hventer/comp4060/Code/Other Code/Temperature Module/Temperature.rtf

https://www.circuitbasics.com/how-to-set-up-the-dht11-humidity-sensor-on-an-arduino/
WORKS

https://create.arduino.cc/projecthub/MisterBotBreak/how-to-use-temperature-and-humidity-dht-sensors-9e5975
https://www.jaycar.com.au/arduino-compatible-temperature-and-humidity-sensor-module/p/XC4520
