hventer/comp4060/Documentation/Project Plan.pdf

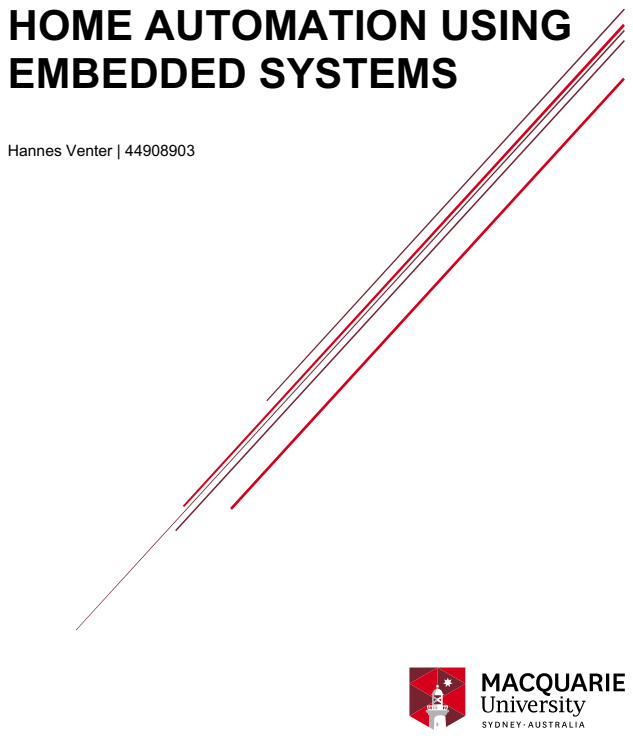
[picture p14: page 1]
Hannes Venter | 44908903

HOME AUTOMATION USING
EMBEDDED SYSTEMS

i

## Table of Contents

ii

iii

## Document Version Record

Table 1 - Table of document versions and revisions

Version | Date | Description | Author
0.0.1 | 18/3/20 | Initial thoughts on CPD project. Began a list of dot-points with ideas for CPD projects. | Hannes Venter
0.0.2 | 19/3/20 | Created Title Page and TOC. Further filled in ideas for CPD project. | Hannes Venter
0.0.3 | 20/3/20 | Selected Final Idea. Wrote topic and motivation. | Hannes Venter
0.0.4 | 22/3/20 | Finalised project timeline and first ideas about how to achieve the project. | Hannes Venter
0.1 | 22/3/20 | Finalised version 0.1 | Hannes Venter
0.1.1 | 25/3/20 | Taking feedback into consideration and improving formality of plan. | Hannes Venter
0.1.2 | 25/3/20 | Moving Initial Plans and Further Motivation into Appendices | Hannes Venter
0.1.3 | 26/3/20 | Further explanation of hardware, software and knowledge | Hannes Venter
0.1.4 | 27/3/20 | Research and selection of hardware and software | Hannes Venter
0.1.5 | 28/3/20 | Purchase and description of hardware and software | Hannes Venter
0.2 | 29/3/20 | Finalised version 0.2 | Hannes Venter
0.2.1 | 4/4/20 | Added pictures to Arduino and Sensors. Added plan diagrams (section 4.4) | Hannes Venter
0.2.2 | 5/4/20 | Improved and added detail to project timeline (section 4.5). Added future expandability section. | Hannes Venter
0.2.3 | 6/4/20 | Proof-read document and made spelling and gramatical improvements. | Hannes Venter
1.0.0 | 6/4/20 | Finalised document (version 1.0.0) | Hannes Venter

## 1. Introduction

This project will consist of 2 smaller projects, both centred around home-automation. The projects will both be embedded systems and will vary in complexity as they progress. Appendix I provides explanations of additional project considerations.

### 1.1 Ceiling Vents

The first project will create a system which draws hot air out of the ceiling, thus cooling the house. A fan will be placed inside the ceiling space with its exhaust directing outwards through a vent. The fan will be enabled once the temperature inside the ceiling reaches above a certain temperature and will run until the ceiling is sufficiently cooled. Light sensors will be implemented to alter the power settings and ensure that the fan is quiet during the night.

### 1.2 Automatic Blinds

The second project will be more complex. This project will enable external blinds to be gradually lowered in front of windows as the sun sets. An array of light sensors and temperature sensors will be used to track the location of the sun. The system will communicate with existing electrical blinds which are to be lowered with the setting sun. This will ensure that the room remains cool during summer and reduces the glare of the sun throughout the room. Additional sensors could be used to raise the blinds during strong winds to prevent any damage.

## 2. Motivation

Motivation for this project arose after reflecting on the multitude of software engineers which exist. Through thought and research, I tried to determine the type of software engineer that I want to be. Embedded systems were found to be most interesting. The aspect of problem solving and creating projects with physical interactions have always been particularly enjoyable. Reflection on the work completed in ENGG200 and ENGG300 instigated the initial idea to undertake a project on embedded systems. There is a significant amount of knowledge and experience that can be personally gained in this field. These projects were thus chosen with a goal of self-improvement, above and beyond the endeavours completed in ENGG200 and ENGG300. Appendix II contains further explanation of motivations for this topic.

## 3. Research

### 3.1 Hardware

3.1.1 Processor

The computing power for the project will be provided by a microprocessor. The initial two selections were between Arduino and Raspberry Pi.

A Raspberry Pi is a fully functional computer, usually with a Linux operating system, and the ability to run multiple programs [1] [2]. Arduino is a microcontroller, which is just a single component of a computer [2]. A microcontroller is a simple computer that can run one program at a time, over and over again [1].

3.1.2 Sensors

The sensors and other components will be selected once a processor has been chosen. These will include temperature sensors, light sensors and wind speed sensors.

3.1.3 Additional Hardware

- Fan/Vent
- Relay which can be triggered to supply power to the fan
- Resistors
- Electronic Blinds
- Remote Control to control blinds
- Wiring capable of handling the different power requirements
- Power supply

### 3.2 Software

Raspberry Pi runs on a Linux operating system [2]. Ubuntu is a free Linux OS which allows additional software and programs to be installed.

Arduino uses its own language and IDE. The Arduino language is in many ways a simplification of C++ [3].

### 3.3 Knowledge

A vast amount of additional knowledge will be required, regardless of which hardware is selected. Initial research will involve determining which processor to select for the control of the system. Additional sensors and components must then be selected to ensure a coherent match with the chosen microprocessor. Once a processor is chosen, a significant amount of research will be conducted into the software which manages it.

This project will require a remarkable amount of hardware knowledge as it is an embedded system. Electrical and computer engineering research will be conducted to maximise safety and minimise any possibility of damage to the components.

## 4. Project Plan

### 4.1 Microcontroller/Processor

This project will not require tremendous amounts of processing power. Arduino was selected due to its ease of use, lower price and reduced processing power. The choice of Arduino hardware was narrowed to the Arduino Uno, Arduino Leonardo and Arduino Mega 2560.

4.1.1 Arduino Uno

The Arduino Uno “has 14 digital input/output pins (of which 6 can be used as PWM outputs), 6 analogue inputs, a 16 MHz ceramic resonator, a USB connection, a power jack, an ICSP header and a reset button” [4].

4.1.2 Arduino Leonardo

The Arduino Leonardo “has 20 digital input/output pins (of which 7 can be used as PWM outputs and 12 as analogue inputs), a 16 MHz crystal oscillator, a micro USB connection, a power jack, an ICSP header, and a reset button” [5].

4.1.3 Arduino Mega 2560

The Arduino Mega 2560 “has 54 digital input/output pins (of which 15 can be used as PWM outputs), 16 analogue inputs, 4 UARTs (hardware serial ports), a 16 MHz crystal oscillator, a USB connection, a power jack, an ICSP header, and a reset button” [6].

4.1.4 Selected Microcontroller

The Arduino Uno (Figure 1) will be the microcontroller
board used in this project. It has sufficient processing power and memory and has enough input/output pins
for the requirements of this project. It is also the most
inexpensive and compact out of the three Arduino

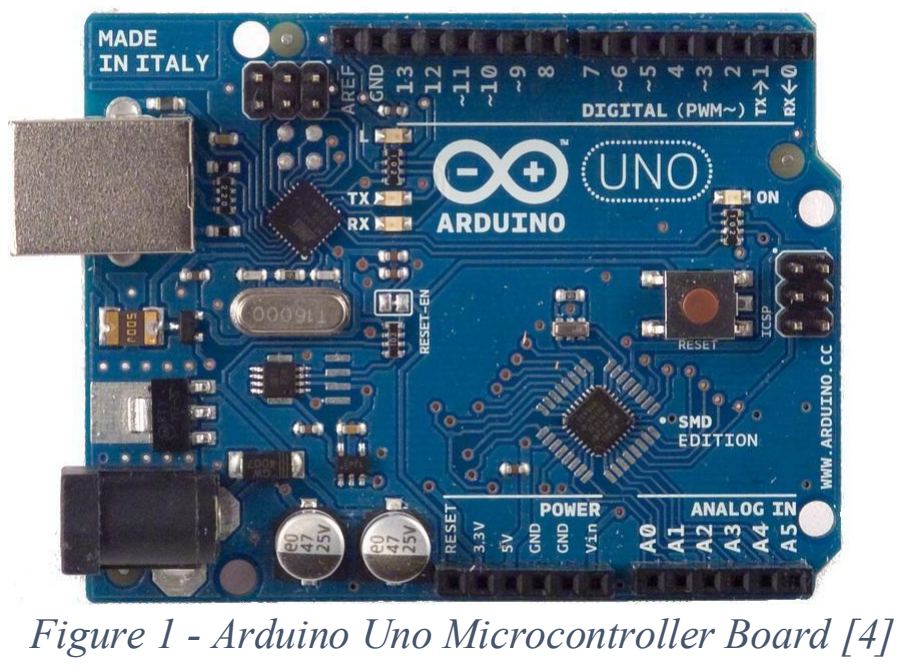
[picture p15: figure]

boards. | Figure 1 - Arduino Uno Microcontroller Board [4]

### 4.2 Software

Thus, C++ will be used as the primary language for this project. Using this language will overcome the limitations of the Arduino language, and enable the functionality of custom-made libraries.

The goal of this project is to program as professionally and efficiently as possible. Libraries will reduce the amount of code required in the main files. It will also allow for OO Programming which will enable multiple sensor objects to be created and controlled using a single library.

### 4.3 Sensors and Additional Hardware

4.3.1 Ultraviolet Sensor Module

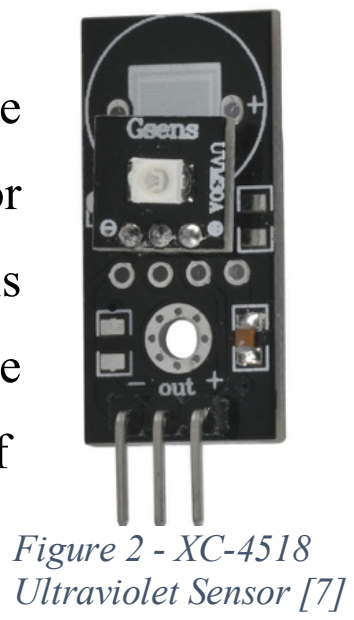
[picture p16: figure]
Figure 2 - XC-4518 Ultraviolet Sensor [7]

Figure 2 shows the XC-4518 Ultraviolet Sensor which was selected to detect the location of the sun. An ultraviolet sensor was chosen over an ordinary light sensor as its readings would be significantly more accurate in detecting sunlight. “This module will measure the UV light and adjust the output voltage depending on the UV intensity” [7]. It is “capable of measuring over a wide spectral range of 200nm-370nm”, has an output voltage 0-1200mV and a current 0.06-0.1mA [7].

4.3.2 Temperature Module

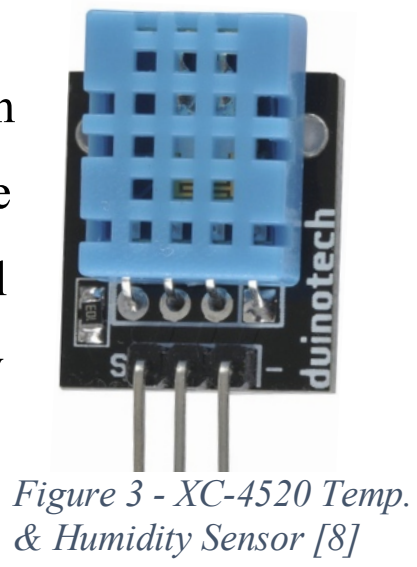
[picture p17: figure]
Figure 3 - XC-4520 Temp. & Humidity Sensor [8]

Figure 3 shows the XC-4520 Temperature and Humidity Sensor Module which was selected to measure the temperature in the different locations. It was the only temperature sensor available, however its additional humidity sensor will be valuable. It has a temperature range of 0 ºC - 50 ºC (+/- 2 ºC) and a humidity range of 20 – 80% (+/- 5%) [8].

4.3.3 Wireless Transmitter

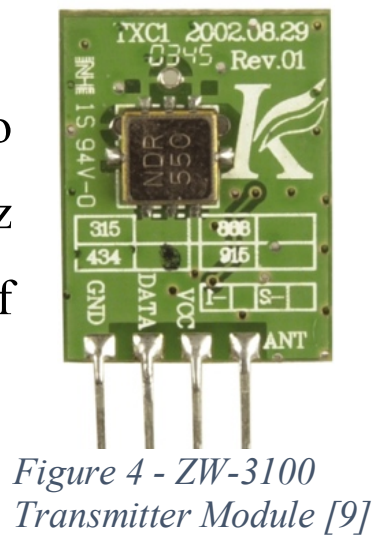
[picture p18: figure]
Figure 4 - ZW-3100 Transmitter Module [9]

Figure 4 shows the ZW-3100 Transmitter Module which was selected to communicate with the existing electrical blinds. This is a pre-built 433MHz wireless transmitter which features ASK encoding [9]. It has an output power of 3dBm, requires 3V and 10mA max inputs, and has a data rate of 300bps to 10kbps [9].

### 4.4 Project Diagrams

4.4.1 Automatic Blinds

Figure 5 is a diagram which provides an overview of the hardware placement for the Automatic Blinds project. Sensors A, B, C and D each have 3 wires connected from the Uno. The wires are a 5 Volt supply, a Ground and a Sensor/Data cable. Sensors A, B and C are UV Sensors. Sensor D is a Temperature and Humidity Sensor.

Sensor A will be placed along the top of the windows and will be the first sensor to detect sunlight. When sunlight reaches sensor A, the blinds will lower halfway.

Sensor B will be placed a third of way up from the bottom of the windows. It will be the second sensor to detect sunlight. When sunlight reaches sensor B, the blinds will lower completely.

Sensor C will be placed at the very top of the windows and will be used to detect when the sun has set. When sensor C no longer detects UV light, the blinds will be raised.

Sensor D will be placed inside to monitor the temperature of the room. If sensor A detects UV light, the blinds will only lower once the temperature is above a certain threshold.

The Transmitter will be connected directly to the Uno and will communicate to the existing receiver in the blinds using Wireless Radio Waves.

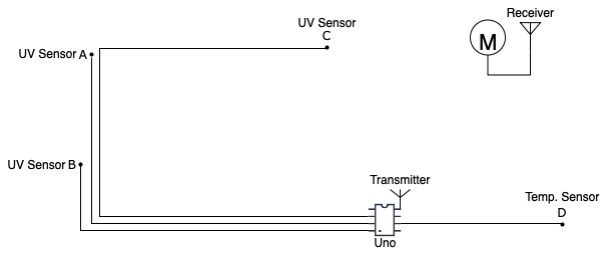
[picture p19: figure]

Figure 5 - Wiring/Sensor Diagram of Blinds Project

4.4.2 Ceiling Fan/Vent

Figure 6 is a diagram which provides an overview of the hardware placement of the Ceiling Fan/Vent project. Sensors A and B each have 3 wires connected from the Uno. The wires are a 5 Volt supply, a Ground and a Sensor/Data cable. Sensor A is a Temperature and Humidity Sensor and sensor B is a UV Sensor.

Sensor A will be placed inside the ceiling space to monitor the temperature of the internal area. Once the temperature reaches above a certain threshold, the Uno will trigger a relay which powers a fan. Sensor A will continue to monitor the temperature, and if the temperature reaches below a certain threshold, the Uno will once again trigger a relay which removes the power to the fan.

Sensor B will be placed outside. Once the sensor stops detecting UV light, the Uno will trigger a relay which removes the power to the fan.

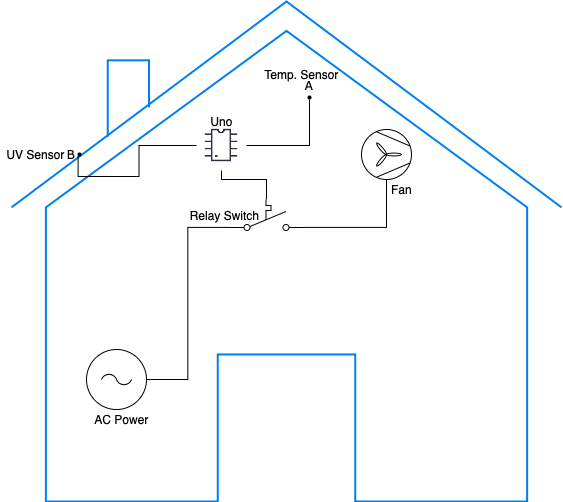
[picture p20: figure]

Figure 6 - Wiring/Sensor Diagram of Fan/Vent Project

### 4.5 Timeline

This project has a timeline of six weeks. Initial work will begin with research as to the most appropriate components for the project, which will be followed by research into the selected hardware and software. The next stage will be prototyping and testing, before building and integrating the components into the larger system. The final stage will be the presentation. Figure 7 provides an overview of the project over the dedicated six weeks.

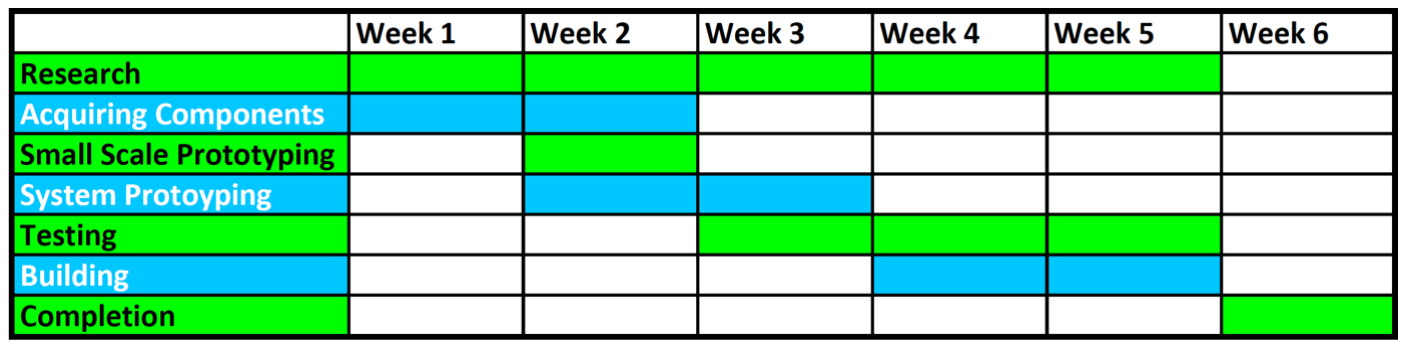
[picture p21: figure]

Figure 7 - Gantt Chart for 6 weeks of the project
4.5.0 Week 0

Week 0 is not technically included in this 6-week project, however it is critical in ensuring the project plan is finalised. This week consist primarily of research, planning and thought.

The research will ensure that a broad variety of ideas are considered for this project. Multiple options will be studied and compared such that the final choices can be selected with confidence. This research will determine which processors, sensors and additional components are the most appropriate options for the project.

Planning throughout this week will determine the number of sensors required to ensure the correct functioning of each project. The planning will consist of distance/length measurements and preliminary diagrams in order to establish the most appropriate position for each sensor. In addition, the required length of wiring and cabling will be calculated.

Constant thought will be placed on this project throughout the week. All primitive thoughts and ideas will be noted and then scrutinised, broadened, developed and placed into the project plan.

4.5.1 Week 1

Week 1 will consist of initial research into the project and any selected components. All initial research will be conducted before any products are handled.

The pins, capabilities, limits and requirements of the Arduino Uno will be researched to ensure a comprehensive knowledge of the product is gained.

The XC-4518 Ultraviolet Sensor and XC-4520 Temperature and Humidity Sensor Module will be thoroughly researched. Any supporting documentation and software will be downloaded and studied to ensure a thorough understanding of the limits and requirements is achieved.

Research for the ZW-3100 Transmitter Module will be more comprehensive since it is a critical component in the project. All supporting documentation and software will be downloaded and studied. Additionally, extensive analysis will be performed on any supplementary support which is available.

Week 1 will also see the purchase of elementary components, once sufficient research has been conducted.

4.5.2 Week 2

Week 2 will consist of continued research and purchasing of necessary equipment.

Initial prototyping will commence once the essential components have been purchased. Each component will be connected to the Uno ensuring that the appropriate pins are matched on both.

Once the XC-4520 Temperature and Humidity Sensor Module is correctly connected, the code found during the research phase will be uploaded to the Uno. Its response will be noted, and any required adjustments will be made to ensure the Sensor Module is functioning. Identical procedures will be conducted with the XC-4518 Ultraviolet Sensor and ZW-3100 Transmitter Module, and their corresponding code.

4.5.3 Week 3

Week 3 will consist of continued research and further prototyping. The prototypes will become more advanced as they progress, and initial small-scale systems will be built. Testing will be introduced to ensure that the various components in the prototypes are performing as intended.

Once the Ultraviolet Sensor has been set up and its code uploaded, a variety of flashlights will be used to test for an appropriate response from the sensor. If the response is not as expected, adjustments will be made to the code, and the sensor will be tested again. When the sensor is responding as expected, it will further be tested outside. The outdoor tests will involve placing the sensor in a diverse range of positions, all with varying levels of sunlight. The corresponding levels of UV exposure will be recorded, and the measurements will form a baseline for the project.

Once the Temperature and Humidity Sensor has been set up and its code uploaded, its measurements will be recorded in a variety of different locations. The locations will range from different rooms inside the house, to an assortment of locations outside. A glass thermometer will be concurrently placed in the same locations, and their measurements will be compared.

These tests will be conducted using all the purchased sensors. Multiple Temperature and Humidity Sensors will be tested simultaneously, and multiple Humidity Sensors will be tested simultaneously, to ensure all their corresponding readings are identical.

Each of the required pins on the Uno will be tested individually to ensure that they all operate as required.

The Transmitter Module will be tested using its supporting software. Its channels and encoding will be customised such that it matches that of the blinds.

After the successful completion of the tests, small-scale prototypes will be built. These will involve multiple different sensors which trigger an event when a requirement is met. An example would involve an LED light illuminating when an Ultraviolet Sensor has a reading above a certain threshold.

4.5.4 Week 4

Week 4 will consist of continued research and testing. The building of the final system will commence after successful testing and performance of the prototypes.

The sensors will temporarily be placed in their dedicated positions. Their measurements will be recorded, and the software conditions will be adjusted such that the system performs as expected. LED light and the Serial Monitor will still be used in place of the Transmitter Module and Vent/Fan relay. If required, small alterations will be made to the sensor locations such that they perform optimally.

4.5.5 Week 5

Week 5 will see significant progress on the build of the project. Continued research and testing will be conducted in conjunction with the build.

The wiring will be finalised, and the sensors will be placed in their permanent locations. The LED prototypes will be replaced with the Transmitter Module and Vent/Fan relay.

Rigorous testing will be conducted on the system as a whole to ensure all components are functioning as expected. These tests will be conducted over numerous days/nights such that a variety of weather conditions and temperatures are encountered.

4.5.6 Week 6

Week 6 will see the conclusion of the project. Any final adjustments will be made to ensure the system is performing optimally. The system will be finalised and made ready for presentation.

## 5. Future Expandability

Both projects have possibilities for future expansion.

The blinds project could be expanded with additional UV sensors to increase the precision of the blinds. These additional sensors would allow the blinds to be lowered in smaller increments and improve the usefulness of the system. Wind speed sensors could also be implemented to retract the blinds when strong winds are detected.

The fan/vent project could be expanded with additional temperature sensors. In this project, the reading from the humidity sensors are ignored and only the temperature readings are accounted for. The accuracy of the system could be improved with a combination of additional sensors and enabling the humidity sensors.

## 6. References

[1] P. Di Justo, “Raspberry Pi or Arduino Uno? One Simple Rule to Choose the Right Board,” 4 December 2015. [Online]. Available: https://makezine.com/2015/12/04/admittedly-simplistic-guide-raspberry-pi-vs-arduino/. [Accessed 26 March 2020].
[2] L. Orsini, “Arduino Vs. Raspberry Pi: Which Is The Right DIY Platform For You?,” 7 May 2014. [Online]. Available: https://readwrite.com/2014/05/07/arduino-vs-raspberry-pi-projects-diy-platform/. [Accessed 26 March 2020].
[3] Arduino, “Language Reference,” 2020. [Online]. Available: https://www.arduino.cc/reference/en/. [Accessed 26 March 2020].
[4] Arduino, “ARDUINO UNO REV3,” 2020. [Online]. Available: https://store.arduino.cc/usa/arduino-uno-rev3. [Accessed 27 March 2020].
[5] Arduino, “ARDUINO LEONARDO WITH HEADERS,” 2020. [Online]. Available: https://store.arduino.cc/usa/leonardo. [Accessed 27 March 2020].
[6] Arduino, “ARDUINO MEGA 2560 REV3,” 2020. [Online]. Available: https://store.arduino.cc/usa/mega-2560-r3. [Accessed 27 March 2020].
[7] JayCar, “Arduino Compatible Ultraviolet Sensor Module,” 2020. [Online]. Available: https://www.jaycar.com.au/arduino-compatible-ultraviolet-sensor-module/p/XC4518. [Accessed 28 March 2020].
[8] JayCar, “Arduino Compatible Temperature and Humidity Sensor Module,” 2020. [Online]. Available: https://www.jaycar.com.au/arduino-compatible-temperature-and-humidity-sensor-module/p/XC4520. [Accessed 28 March 2020].
[9] JayCar, “Wireless Modules (Transmitter) - 433MHz,” 2020. [Online]. Available: https://www.jaycar.com.au/wireless-modules-transmitter-433mhz/p/ZW3100. [Accessed 28 March 2020].
[10] L. Pasqualis, “19 Types of Developers Explained,” 16 August 2017. [Online]. Available: https://www.coderhood.com/19-types-of-developers-explained/. [Accessed 19 March 2020].

## Appendix I: Initial Project Ideas

After reflection and research of what kind of SE I want to be, I decided to complete a project on embedded systems.

NFC Door lock

Initials thoughts were to create an NFC enabled door lock that unlocks when a registered phone is tapped. An adverse realisation was that there are already too many systems that offer this and would perform significantly better. Another unfavourable insight was the extreme security requirements of this project, since it will control access to the house.

Automatic Lights

Another thought was to create a system that controls the lights in the garden. The lights would turn on when the sun sets and it becomes dark, and then turn off when it becomes light again. This idea was disregarded as it seemed too elementary.

Automatic Blinds

Our family room has windows on three of its walls, meaning that the afternoon sun is very prominent. Existing external blinds can be lowered and raised using a remote control. We often lower it in stages as the sun sets in the afternoon. Once the sun has set, we raise it again.

This produced the idea to create a system that uses light sensors at certain increments to lower the blinds gradually as the sun sets and raises it again once the sun has set. In winter, the sun naturally warms the room reducing the need for heaters. The light sensors could thus be combined with a thermometer, which only lowers the blinds once the room reaches above a certain temperature.

Ceiling Vents

The final idea was to place a vent/fan in the upstairs ceiling which turns on once the temperature in the ceiling space rises above a certain threshold.

## Appendix II: Project Motivation

I have always enjoyed problem solving. Most of software engineering has some form of problem solving in it.

This past week, I have intensely thought about the type of software engineer that I want to be. I thought back about the subjects I did and which ones I enjoyed most. COMP247 stood out, however this was more because it was directly relatable my work as an IT consultant at a school. Through my work there, I have often had to change the VLANs on switch-ports, change the IP address of various devices and interact with servers, routers and switches via the command line interface.

Something that I’ve admired greatly is the new metro. I am in awe of the software and hardware that makes that system work. It would be nice to be able to know that I had a role in something such as that.

To support my reflections, I decided to do some research on the different types of software engineers and what they all actually do [10].

I noticed the difference between a high-level developer and a low-level developer. Low-level seems to interact more with hardware and seemed interesting.

“This is a general term for a developer who writes code that is very close to the hardware, in low-level languages such as assembly and C. Embedded developers are often low-level developers, but not always.” [10]

The main one that really stood out to me was an embedded developer.

“These developers work with hardware that isn’t commonly classified as computers. For example, microcontrollers, real-time systems, electronic interfaces, set-top boxes, consumer devices, iOT devices, hardware drivers, and serial data transmission fall into this category. [10]

Embedded developers often work with languages such as C, C++, Assembly, Java or proprietary technologies, frameworks, and toolkits.” [10]

Both ENGG200 and ENGG300 have shown me how enjoyable it is to work with embedded systems. I really enjoy seeing physical actions from my code. It is also heavily centred around problem solving and actually working with real things.
