hventer/comp4060/Code/Other Code/UV Sensor Module/UVMeter/UVMeter.ino

String UV = "0"; 

void setup() {
  Serial.begin(9600);
}

void loop() {
 
 //int stringLength = 0; 
  
 UV = readSensor();
 
 //stringLength = UV.length();
 Serial.println(UV);

 delay(500);
}

String readSensor()
{
  Serial.println("----readSensor()---");
  String UVIndex = "0";
  int sensorValue = 0;
  
  sensorValue = analogRead(0);                        //connect UV sensor to Analog 0
  Serial.println(sensorValue);
  int voltage = (sensorValue * (5.0 / 1023.0))*1000;  //Voltage in miliVolts
  Serial.println(voltage);
  
  if(voltage<50)
  {
    UVIndex = "0";
  }else if (voltage>50 && voltage<=227)
  {
    UVIndex = "0";
  }else if (voltage>227 && voltage<=318)
  {
    UVIndex = "1";
  }
  else if (voltage>318 && voltage<=408)
  {
    UVIndex = "2";
  }else if (voltage>408 && voltage<=503)
  {
    UVIndex = "3";
  }
  else if (voltage>503 && voltage<=606)
  {
    UVIndex = "4";
  }else if (voltage>606 && voltage<=696)
  {
    UVIndex = "5";
  }else if (voltage>696 && voltage<=795)
  {
    UVIndex = "6";
  }else if (voltage>795 && voltage<=881)
  {
    UVIndex = "7";
  }
  else if (voltage>881 && voltage<=976)
  {
    UVIndex = "8";
  }
  else if (voltage>976 && voltage<=1079)
  {
    UVIndex = "9";
  }
  else if (voltage>1079 && voltage<=1170)
  {
    UVIndex = "10";
  }else if (voltage>1170)
  {
    UVIndex = "11";
  }
  return UVIndex;
}
